plane-paper/Catfeeder/5F897B19-BFA4-4545-864E-5A976C4CB3A6.jpg

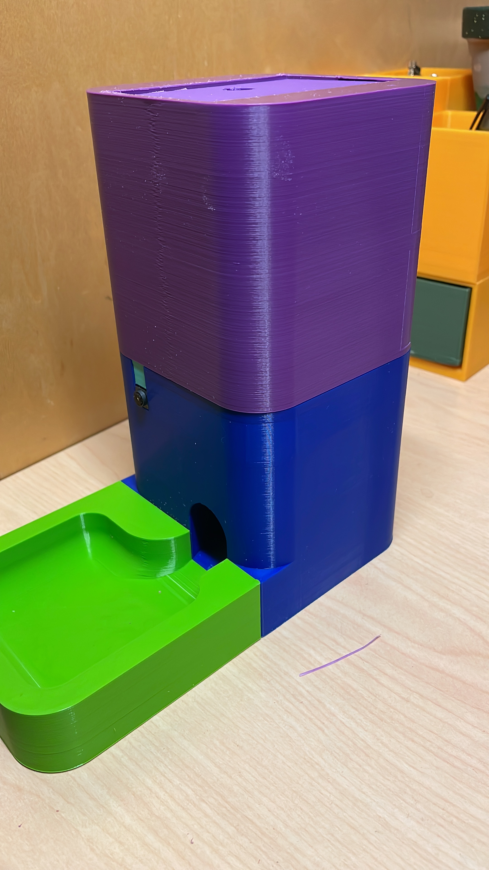
5F897B19-BFA4-4545-864E-5A976C4CB3A6.jpg
