plane-paper/Catfeeder/73BFDE24-248B-4256-BA10-98AE62F0195C.jpg

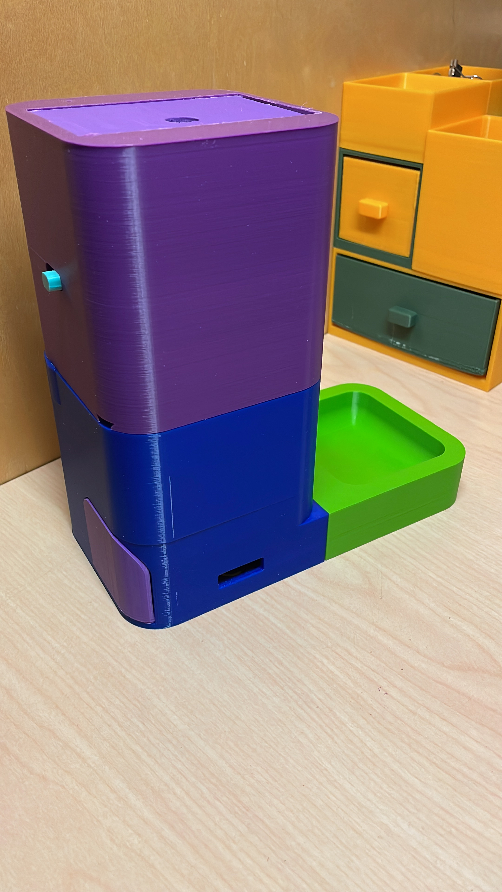
73BFDE24-248B-4256-BA10-98AE62F0195C.jpg
