plane-paper/Catfeeder/Cat feeder v4.pi holder v5.stl

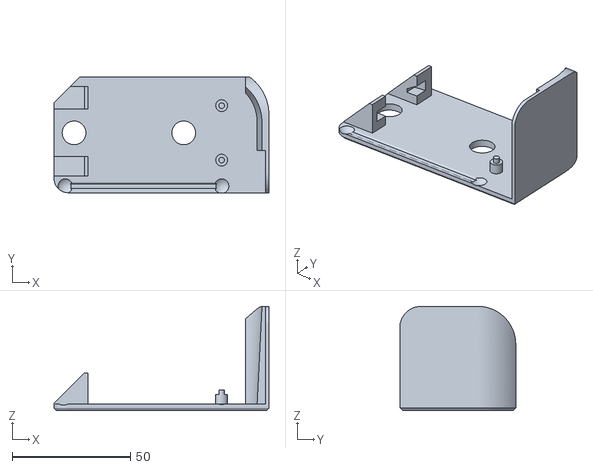
[picture p7: CAD file, 2022-04-14]
Cat feeder v4.pi holder v5.stl
90.8 x 48.8 x 44.0
