plane-paper/Catfeeder/Cat feeder v4.door gear box v1.stl

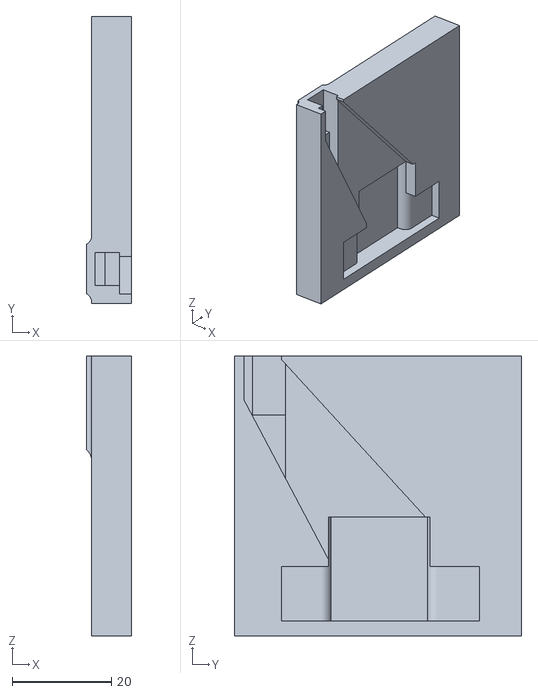
[picture p8: CAD file, 2022-04-14]
Cat feeder v4.door gear box v1.stl
9.00 x 58.0 x 56.5
