plane-paper/Catfeeder/Cat feeder v4.feederv3.stl

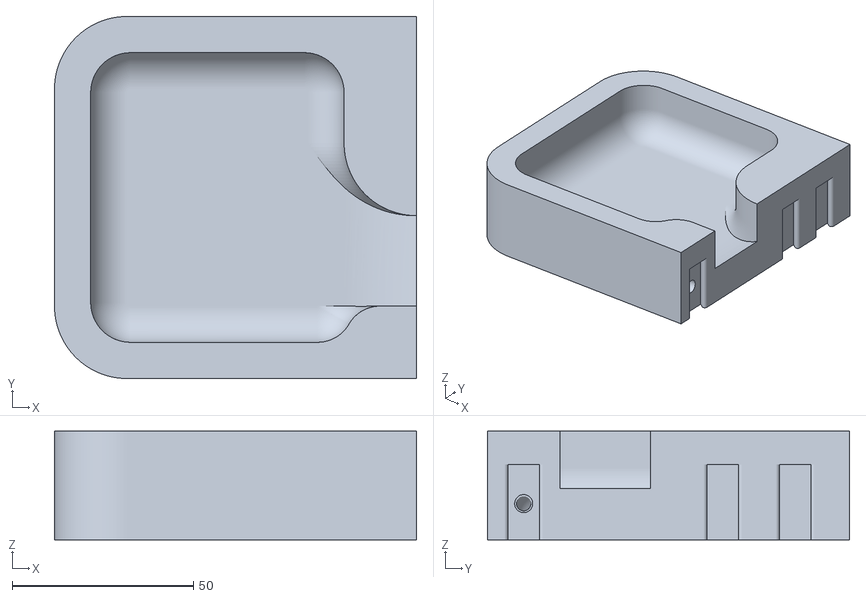
[picture p9: CAD file, 2022-04-14]
Cat feeder v4.feederv3.stl
100.0 x 100.0 x 30.0
