plane-paper/Catfeeder/Cat feeder v4.rail blocker(optional).stl

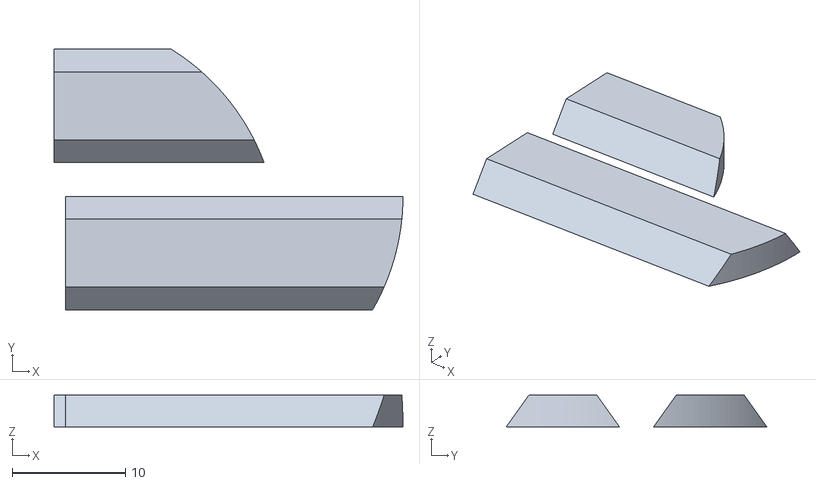
[picture p10: CAD file, 2022-04-14]
Cat feeder v4.rail blocker(optional).stl
30.8 x 23.0 x 2.80
