plane-paper/Catfeeder/Cat feeder v4.top door.stl

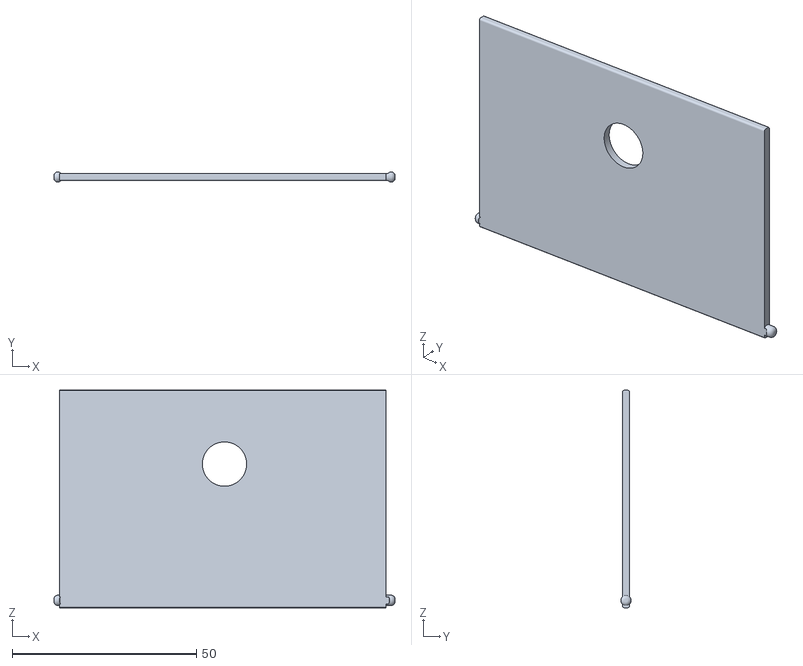
[picture p11: CAD file, 2022-04-14]
Cat feeder v4.top door.stl
92.5 x 2.80 x 59.0
