plane-paper/Catfeeder/Cat feeder v4.Bgearingv2.stl

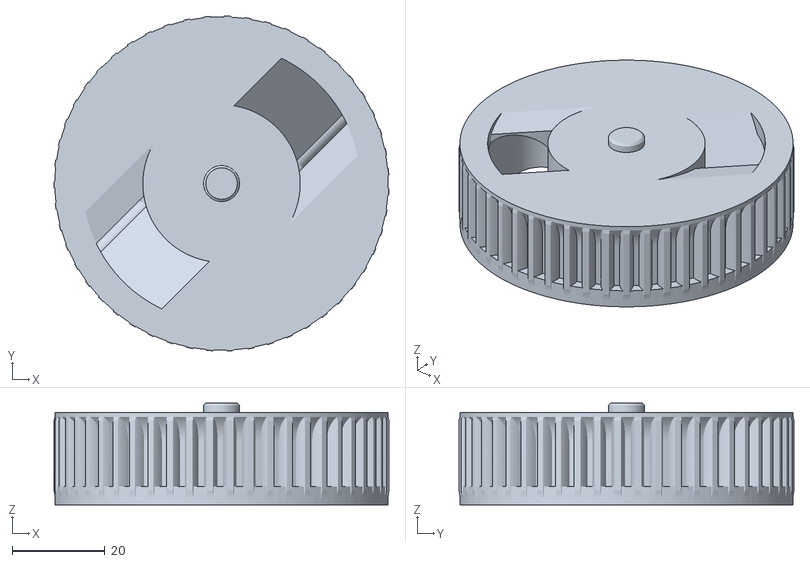
[picture p12: CAD file, 2022-04-08]
Cat feeder v4.Bgearingv2.stl
72.4 x 72.4 x 22.0
