plane-paper/Catfeeder/Cat feeder v4.netv2.stl

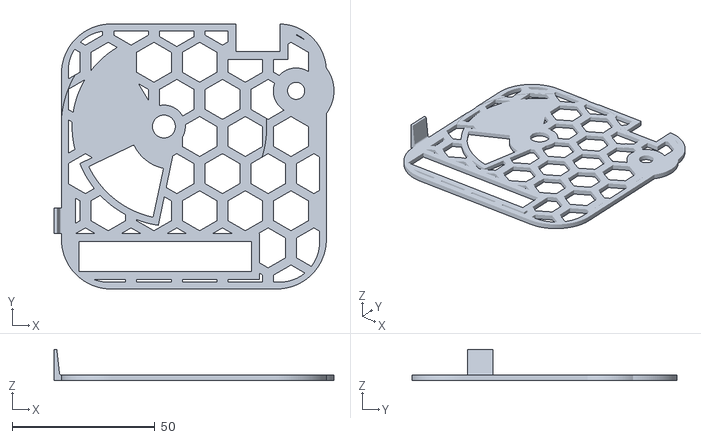
[picture p13: CAD file, 2022-04-08]
Cat feeder v4.netv2.stl
98.1 x 92.8 x 11.0
