plane-paper/Catfeeder/Cat feeder v4.upperv1.stl

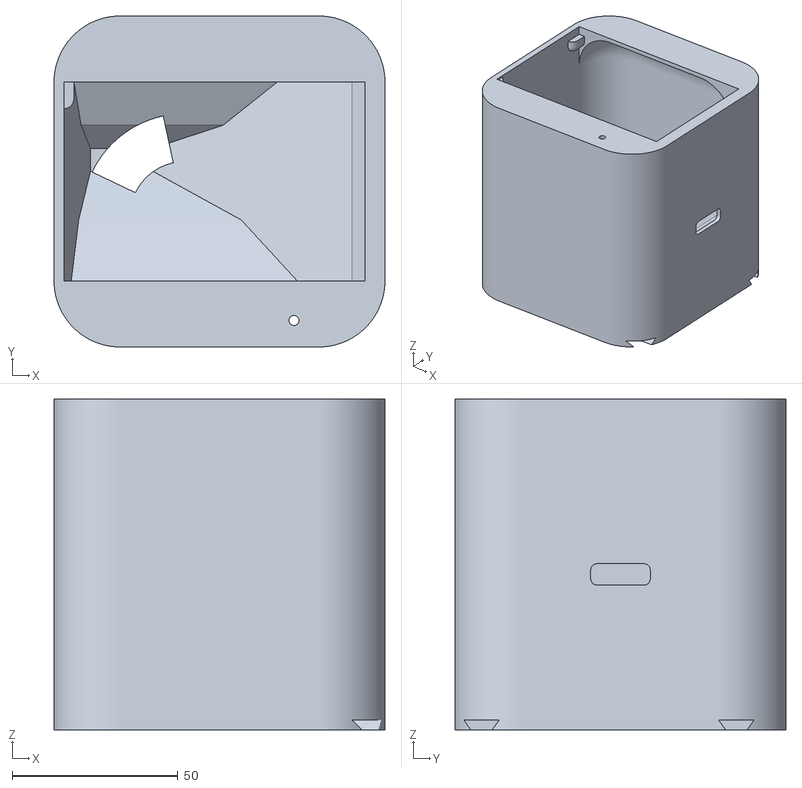
[picture p14: CAD file, 2022-03-17]
Cat feeder v4.upperv1.stl
100.0 x 100.0 x 100.0
